heavy-oil1462/vippa/docs/CONCEPT.md

# Concept

A Vippa panel is a slab of hardwood (oak, walnut) or brass with panel
hardware set into its face. It hangs on a wall or stands on a desk and
controls Home Assistant through an ESP32 behind it. It should feel like
a piece of old lab equipment: heavy, deliberate, no screen.

## Component families

Each family becomes catalog entries (catalog/components.json) with
measured or datasheet values.

- Toggle switches: full size (12 mm, 15/32 in bushing) and miniature
  (6 mm, 1/4 in bushing), bat handles. On/off and momentary. The first
  family in the catalog.
- Rotary controls: incremental encoders with push (for dimmers and
  volume) and multi-position rotary switches (scene selectors), with
  machined or bakelite knobs.
- Pushbuttons: momentary, metal, optionally illuminated.
- Pilot lamps: bezel indicators, LED inside.
- Analog meters: moving-coil panel meters driven by ESP32 PWM, with
  printed custom scales (temperature, power, anything HA knows).

## How a panel is made

1. Describe the panel in `panels/<name>.json`: board, cavity and the
   components with their positions from the reference corner.
2. `python3 scripts/regen_all.py` checks it and writes both templates.
3. Mark the reference edges on the board (bottom and left seen from the
   front). Seat the punch template on the front face, fences hard
   against both edges, and punch every hole center.
4. Drill each hole from its punch mark; the template is engraved with
   the drill size next to each bore.
5. Turn the board over its long edge. Seat the router template on the
   back, fences on the same two edges, and route the cavity with the
   guide bushing against the template. The template is engraved with
   the bushing, bit and depth it was made for.
6. Fit the hardware, wire it to the ESP32 in the cavity, close the back.

## Decisions

- Board thickness, cavity rim, corner radius and face thickness are per
  panel, in the panel JSON.
- Templates register on edge fences along two reference edges. A
  diamond relief groove runs along each fence root so an eased arris or
  dust cannot lift the template.
- Front template bores guide the center punch only, sized from the
  measured punch nose. Drilling is freehand from the mark.
- The cavity is routed by hand with a guide bushing against a printed
  template, not drilled or CNC cut. The template extends router_margin
  past the board on every side so the router base stays supported.
- Controls are centered on the face: the bounding box of the components
  sits on the board's center lines, unless the panel says why not. The
  internals (battery holder, ESP32 board) find room in the cavity around
  the controls, and the board grows to fit them, not the other way
  round. scripts/panels.py reports an off center panel as [info].
- Panel configs are JSON (stdlib, validated before rendering, readable
  by the firmware generator later).

## Radio

Zigbee, as a sleepy end device on an ESP32-H2, through the user's
existing Zigbee coordinator (ZHA or Zigbee2MQTT). No wifi, no bridge.

Why: the delay that makes smart switches feel slow is the device
rejoining wifi and Home Assistant after each wake. A Zigbee end device
stays joined to its parent while it sleeps, so a toggle wakes it and the
report goes out at once, the way commercial battery switches work.
Zigbee also acknowledges every frame, which keeps the lever and the
light in agreement.

How it was chosen (2026-10-21):

- ESPHome has official Zigbee end device support on ESP32-C6 and H2;
  its docs call the H2 more reliable. Support is basic: Home Automation
  profile only, and a config change usually means re-pairing.
- ESPHome has no Matter support. Its OpenThread component carries the
  normal ESPHome API over Thread, the same connect handshake as wifi.
  Matter would mean leaving ESPHome.
- ESP-NOW to a plug-in bridge was the fallback: fast and all ESPHome,
  but one more device in the house.
- Risk: ESPHome documents its sleepy option for nRF52 only. Sleep
  current and flip to light latency on the H2 must be measured on a
  dev kit before the hardware is final. Target: under 300 ms.

The antenna works at 2.4 GHz like wifi, through the wood:

- Dry hardwood costs a few dB at panel thicknesses, not enough to
  matter in a house. Wet or green wood costs much more: oil the panel,
  never mount it fresh.
- Metal is what kills the signal. A PCB antenna needs a zone with no
  metal around its end: no battery can, switch body or wire bundle in
  it. The panel check enforces this with the module's antenna_keepout,
  so the board lies with its antenna end toward a cavity wall.
- A metal back cover, a metal wall box or a brass face shields the
  antenna completely. Those need a board with an external antenna
  connector (u.FL) and the antenna placed in wood or out in the open.
- Wall mounting puts the wall behind the antenna; plaster and wood are
  fine, a metal stud or a mirror behind it is not.

## Power

Battery powered, two AA cells end to end in a printed inline holder
screwed to the cavity floor, never side by side or stacked. In line the
cells are in series by touching nose to tail, so the holder needs bought
contacts only at its two ends: a spring for the negative end and a flat
plate for the positive. The long, narrow holder fits the band of cavity
beside a centered row of controls. The ESP32-H2 sleeps as a Zigbee sleepy end device, polling its
parent now and then, and wakes at once when a toggle moves.

Budget for two alkaline AA (about 2500 mAh, of which perhaps 2000 mAh
is usable through a regulator). Unlike wifi, a flip costs almost
nothing (a short radio burst), so the average sleep current, poll
wakes included, sets the battery life:

| Average sleep current | Per day | Two AA last |
| --- | --- | --- |
| 20 uA | 0.5 mAh | years, limited by the cells' shelf life |
| 100 uA | 2.4 mAh | about 2 years |
| 500 uA | 12 mAh | about 5 months |

The ESP32-H2 figure is not known yet for ESPHome; measuring it is the
first firmware task. Things that decide it:

- The board. A typical dev board with a USB serial chip, a common LDO
  and a power LED draws several mA asleep, which empties the cells in
  weeks. It has to be a board made for deep sleep, or a bare module.
- The regulator. Two AA give 3.2 V fresh and about 2 V flat; the ESP32
  wants 3.0 to 3.6 V. A buck boost with a quiescent current under a
  microamp uses the whole cell. Lithium AA (1.5 to 1.8 V flat curve)
  give more capacity and work in the cold. NiMH (2.4 V for two) needs
  the boost too.
- The poll period: how often the sleeping device asks its parent for
  messages. Longer polls save power; a switch only sends, so it can
  poll rarely.
- Switch wiring. A closed toggle on a pull up resistor draws current
  for as long as it is on: about 70 uA through the ESP32's internal
  pull up, more than the whole sleep budget. Use ON-ON (SPDT) toggles
  wired between 3.3 V and ground, which hold the pin at a level with no
  current, or very high value external pull ups.
- Waking on a change. A toggle left on holds its pin high, so the wake
  must be armed per pin for the opposite of its current level before
  each sleep. The chip variant decides how easy that is; settle it with
  the firmware.

The holder's screws go into the 4 mm face from behind. panel.scad
asserts that holder_screw_len minus holder_flange_t stops face_skin
short of the front; with the defaults a 2.2 x 4.5 screw reaches 2.5 mm
into the oak. Drill the pilot holes with a depth stop.

## Firmware

ESPHome (ADR-0002), generated from the panel JSON by scripts/firmware.py
into build/panels/<name>/<name>.yaml and checked with `esphome config`
by regen_all.py. The config only includes the packages in
firmware/packages/: h2_base.yaml (the chip and deep sleep), zigbee.yaml
(the radio, ADR-0003) and one package per component family.

- Each toggle is a Zigbee binary input named after its component id,
  reported on every change (`report: force`), internal pull resistors
  off for the ON-ON wiring above.
- Pins come from the panel's `"pin"` or a fixed order in
  scripts/panels.py, wake capable pins first (ADR-0004).
- The panel deep sleeps, wakes every `poll_period`, rejoins its parent,
  reports and sleeps again after `awake_time`.

## Open questions

- Firmware gaps in ESPHome 2026.5.1 on the ESP32-H2 (the nixpkgs pin),
  not worked around with custom C++ (ADR-0002):
  - No sleepy end device: ESPHome's `sleepy` option is nRF52 only. The
    H2 deep sleeps and rejoins its parent after every wake instead of
    staying joined and polling. The cost in wake time and current has
    to be measured on the dev kit.
  - No wake level per pin: deep sleep on the H2 wakes through ext1 with
    one level for every pin, and ESPHome's single `wakeup_pin` with
    INVERT_WAKEUP is not implemented on the H2. So the firmware cannot
    arm each toggle for the opposite of its level, and wakes on the
    timer only, an interim default in h2_base.yaml and not a decision:
    a flip waits up to `poll_period`. ext1 is left out because with
    one level for all pins, a toggle left at that level would wake the
    panel again at once and drain the cells. Options:
    wait for ESPHome, or add per pin ext1 levels to ESPHome upstream
    (ESP-IDF supports them on the H2).
  - No trigger for an acknowledged report: the panel sleeps after
    `awake_time` instead of as soon as the parent acknowledges.
  - Only five H2 GPIOs can wake it (10 to 14), so at most five
    toggles per panel can wake the panel once per pin wake works.
- Charging: none for alkaline cells, or a board with a charger for
  rechargeable cells.
- Back of the panel: a cover plate in a rebate, or a screwed panel.
  Needs a second, shallower router template step.
- Anti-rotation for toggles: a second small hole for the lock washer tab,
  or rely on the nut torque.
- Mounting: wall (keyhole, French cleat) and desk (angled base).
- The ESP32 board: generic placeholder for now. Holding it in the
  cavity: printed tray screwed like the battery holder.
- Boards larger than the print bed: split templates or a two-step
  registration.
- Brass panels: same templates, or a separate path.
