heavy-oil1462/vippa/(commit log)

2026-10-21 Scaffold the repo: pipeline, gates, skills and concept
    Layout and tooling follow hamstra and skua: a shared design_params.scad
    guarded by check_params.py, a single regen_all.py entry point with a
    read-only --check gate, headless OpenSCAD through a pinned nix build,
    and the verify, regen-outputs and openscad-review skills.
    New here: check_style.py gates the writing rules (no em dashes, emoji
    or bold) across every tracked text file, and a drill guide gauge is the
    first calibration model. docs/CONCEPT.md holds the concept and the open
    questions for the hardware phase.
2026-10-21 First panel: JSON panel configs, punch and router templates, hero renders
    A panel is now panels/<name>.json, validated against a component
    catalog (catalog/components.json) before anything renders, and turned
    into a generated OpenSCAD wrapper. cad/lib/panel.scad builds the board,
    the front punch template and the back router template from it; both
    templates register on edge fences along the two reference edges.
    The first panel is an oak slab with three toggles. Its catalog values
    are placeholders, flagged measured: false until calipered.
    README images are photoreal Cycles renders, ported from pourbot's
    pipeline: colored 3MF, split per material, headless Blender.
    New skills: panel-config, c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
2026-10-21 Room for the ESP32 and two AA cells, Zigbee radio decision
    Panels gain internals: catalog modules (an ESP32 board, a battery
    holder) placed in the cavity. panels.py checks they fit the cavity
    depth and outline, keep 2 mm clear of the wall, each other and every
    switch body, and that no metal sits in a module's antenna keepout.
    The battery is two AA cells in a printed holder (cad/holders/), screwed
    to the face underside from inside the cavity. panel.scad asserts the
    screws stop face_skin short of the front, and regen_all.py fails if the
    holder's STL envelope differs from its catalog size.
    docs/CONCEPT.md records the radio (Zigbee sleepy end device on an
    ESP32-H2, for instant response on batt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
2026-10-25 Direction: goal, principles, architecture and priorities
    Includes the owner's board direction of 2026-10-25: controls centered,
    AA cells end to end in a printed inline holder.
2026-10-25 CI: run the verify gate on every pull request and push to main
    .github/workflows/verify.yml installs nix and runs regen_all.py --check,
    with OpenSCAD and Mesa from the pin in render_scad.py and the nix store
    cached between runs. CLAUDE.md, TODO.md and the render_scad.py docstring
    no longer describe the ci-workflow branch or an xvfb AppImage.
2026-10-26 Center the switch row, inline AA holder below it
    The switches sit on the board's vertical center line again. The battery
    holder now carries the two AA cells end to end (in series by touching,
    so contacts only at the two ends) and runs along the band under the
    switches; the ESP32 board moves to the band above, antenna toward the
    end wall. The board grows from 100 to 110 mm tall so both bands fit.
    README renders regenerated.
2026-10-26 Smallest centered board, centering check, docs
    Row on the board center at 190 x 107: 107 mm is the smallest height
    the cavity checks allow with the row on h/2 and the ESP32 board above
    it (106 puts the board within 2 mm of the cavity wall). The ESP32
    moves to y 77 to suit.
    panels.py reports [info] when the bounding box center of a panel's
    components is more than 1 mm off the board center. CONCEPT.md records
    the inline holder in Power and the centered controls in Decisions; the
    panel-config skill starts a new panel from a centered row.
2026-10-26 Regenerate README renders for the 190 x 107 board
2026-10-26 Firmware: ESPHome config generated from each panel
    Hand written packages in firmware/packages (H2 base with deep sleep,
    Zigbee radio, toggle), scripts/firmware.py writes
    build/panels/<name>/<name>.yaml from the panel and catalog, and
    regen_all.py validates every generated config with esphome config from
    the nixpkgs pin. panels.py validates an optional pin per component and
    fills in the rest in a fixed order; three_toggles sets its pins.
2026-10-26 Example panels: bedside, hallway, scenes; toggle_6mm placeholder
    bedside (walnut, 175 x 93): one full size toggle centered, the ESP32
    board beside it, antenna toward the right wall, the holder below.
    hallway (oak, 162 x 107): two toggles 50 mm apart, the ESP32 board
    above and the holder below, like three_toggles.
    scenes (oak, 166 x 123 x 22): six miniature toggles at 30 mm pitch,
    the holder below, the ESP32 board turned 90 beside the rows with the
    antenna toward the top wall.
    Each board is the smallest the checks allow with the controls on the
    board center lines. toggle_6mm carries datasheet style placeholders,
    measured false.
2026-10-26 render_hero: --panel and --panels, walnut
    --panel renders the shots of another panel (into --out, so media/ keeps
    the three_toggles shots); --panels renders the hero shot of every panel
    into media/panels/<name>.png. The board's color tag renders as the
    panel's board material: panels.py checks it is one of WOODS, and
    hero_scene.py has a walnut beside the oak.
2026-10-26 Split ADR-0004 to pins only, accepted; supervisor accepts ADRs
    The timer only wake is not a decision: it stays the interim default in
    h2_base.yaml and a known gap under Open questions in CONCEPT.md, for
    the owner to settle. The ADR README states how Proposed ADRs are
    accepted.
2026-10-26 Encoder, rotary switch and pushbutton families, dimmer and living_room panels
    Catalog placeholders, panels.py families with named pins and ADC pins
    for the rotary switch, stand-ins in panel.scad, firmware packages and
    the knob materials for the renders.
2026-10-26 LED segment display family: catalog, panel checks, window and bezel, firmware
    A display sits in the cavity behind a window routed through the face,
    its LED block reaching into a printed bezel on the face. panels.py
    places it like a component and checks the bezel, the digits against the
    face, the module body and the knob it shows; check_panel_rules.py gives
    each check a case that fails it. The router template gets a step plate
    for the window, the punch template bores at its corners. display.yaml
    lights a TM1637 display for display_time after an event.
2026-10-26 Display docs, ADR-0006 and ADR-0007, thermostat pictures
    CONCEPT.md: LED segment displays replace analog meters for readouts,
    meters move to Open questions as not now, the display's power budget,
    and the gaps: no Home Assistant value can reach an H2 panel over
    Zigbee yet, and the module's standby current is unmeasured. ADR-0006
    (the window routed through with a step plate in the router template)
    and ADR-0007 (display pins after the wake and ADC pins), both Proposed.
    render_hero.py renders the thermostat's back as well, with a lit LED
    material.
2026-10-26 Direction: LED segment displays lit after an event, meters not now
2026-10-26 Pilot lamp family: catalog, panel checks and rule cases, stand-in, firmware, garage panel
    pilot_lamp_12mm (family lamp, placeholder values) mounts like a
    pushbutton and is an output family (ADR-0007). A lamp follows a toggle,
    an encoder's push or a pushbutton on its panel and lights for
    display_time after its event. lit.yaml now holds display_time and the
    deep sleep hold for displays and lamps alike.
2026-10-26 Pilot lamps in the docs and skills, lit lens material tuned
    CONCEPT.md settles the lamp's behaviour in Component families,
    Power and Firmware, and widens the Home Assistant value question to
    lamps. README, TODO.md, CLAUDE.md and the component-catalog,
    panel-config and firmware skills follow.
2026-10-26 Bill of materials generated from each panel
    scripts/bom.py writes build/panels/<name>/bom.md from the panel, the
    catalog and design_params.scad: buy, print, wood, tools, wiring and the
    parts not measured yet. regen_all.py writes it for every panel and
    checks its Wiring pins against the panel's ESPHome config, so the two
    cannot drift. Catalog entries gain an optional buy object (a part to
    search for and the extras it needs), validated in panels.py, with no
    links, prices or part numbers.
